eduardomartinez-profile/site-luxif/documento/latex/figuras/esquema.tex

\begin{circuitikz}[american, scale=0.95, transform shape]
  % Arduino
  \draw[thick] (0,0) rectangle (3,9);
  \node[align=center, font=\bfseries] at (1.5,4.6) {Arduino\\Uno};

  % Pinos do lado direito: faixas e leitura
  \foreach \y/\p in {8.5/D2, 7.5/D3, 6.5/D4, 5.5/D5} {
    \node[anchor=east, font=\small] at (3,\y) {\p};
  }
  \node[anchor=east, font=\small] at (3,3.5) {A0};

  \draw (3,8.5) -- (4,8.5) to[R, l=$1\,\mathrm{k\Omega}$] (6.5,8.5) -- (7.5,8.5);
  \draw (3,7.5) -- (4,7.5) to[R, l=$10\,\mathrm{k\Omega}$] (6.5,7.5) -- (7.5,7.5);
  \draw (3,6.5) -- (4,6.5) to[R, l=$100\,\mathrm{k\Omega}$] (6.5,6.5) -- (7.5,6.5);
  \draw (3,5.5) -- (4,5.5) to[R, l=$470\,\mathrm{k\Omega}$] (6.5,5.5) -- (7.5,5.5);
  \draw (7.5,8.5) -- (7.5,3.5);
  \foreach \y in {7.5, 6.5, 5.5} { \fill (7.5,\y) circle (2pt); }
  \draw (3,3.5) -- (7.5,3.5);
  \fill (7.5,3.5) circle (2pt);
  \draw (7.5,3.5) to[phR, l=LDR] (7.5,1) node[ground]{};

  % LEDs azuis do lado esquerdo
  \foreach \y/\p in {8.5/D6, 7.5/D7, 6.5/D8, 5.5/D9} {
    \node[anchor=west, font=\small] at (0,\y) {\p};
    \draw (0,\y) -- (-0.8,\y) to[led] (-2.4,\y) to[R, l_=$1\,\mathrm{k\Omega}$] (-4.6,\y) -- (-5.2,\y);
  }
  \node[font=\small] at (-1.6,9.3) {LEDs azuis};
  \draw (-5.2,8.5) -- (-5.2,4.8) node[ground]{};
  \foreach \y in {7.5, 6.5, 5.5} { \fill (-5.2,\y) circle (2pt); }

  % Alimentação
  \node[anchor=west, font=\small, align=left] at (0,2.5) {Conector\\[-2pt]de energia};
  \node[anchor=north, font=\small] at (1.5,0.6) {GND};
  \draw (-6.5,0) to[battery1, l=$9\,\mathrm{V}$] (-6.5,2.5)
        to[nos, l=chave] (-3.5,2.5) -- (0,2.5);
  \fill (-2,2.5) circle (2pt);
  \draw (-2,2.5) to[led, l_=\small vermelho] (-2,0.6) to[R, l=$1\,\mathrm{k\Omega}$] (-2,-1) -- (-2,-1.3);
  \draw (-6.5,0) -- (-6.5,-1.3) -- (1.5,-1.3) -- (1.5,0);
  \fill (-2,-1.3) circle (2pt);
  \draw (1.5,-1.3) node[ground]{};

  % Display OLED: alimentado por 5V e GND, dados em A4 (SDA) e A5 (SCL)
  \draw[thick] (0.1,10.6) rectangle (2.9,11.6);
  \node[font=\small\bfseries] at (1.5,11.1) {Display OLED};
  \foreach \x/\p in {0.4/GND, 1.1/5V, 1.9/A4, 2.6/A5} {
    \draw (\x,9) -- (\x,10.6);
    \node[anchor=south, font=\scriptsize] at (\x,9) {\p};
  }
\end{circuitikz}
