eduardomartinez-profile/site-luxif/imagens/esquema-eletrico.png

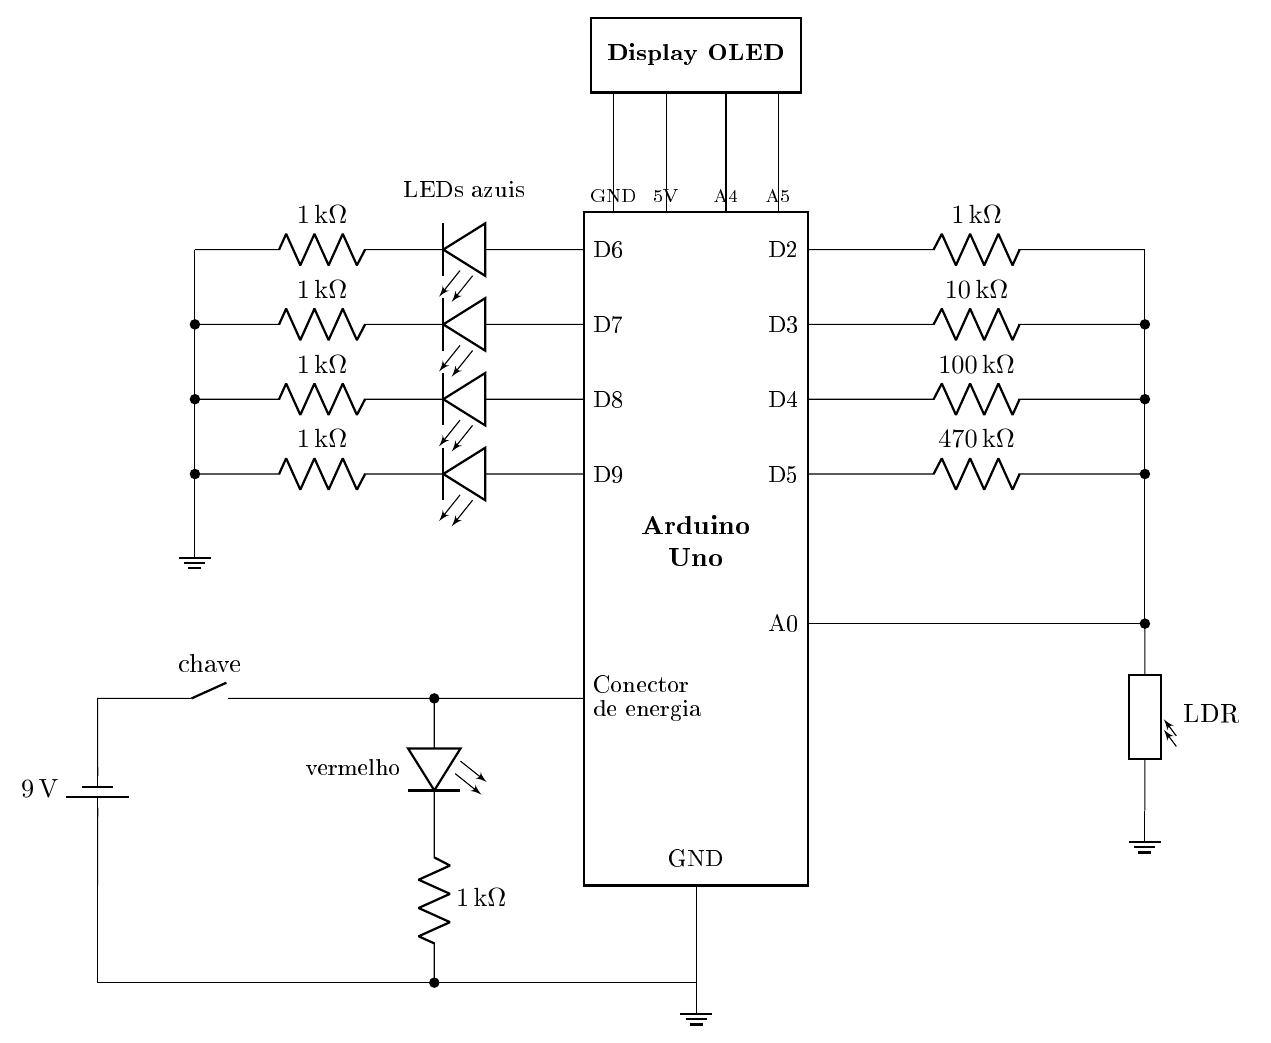
imagens/esquema-eletrico.png
