eduardomartinez-profile/site-luxif/imagens/grafico-divisor.png

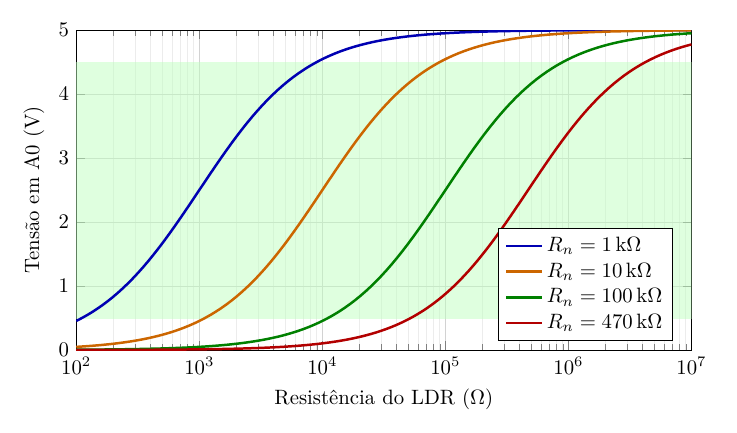
imagens/grafico-divisor.png
