eduardomartinez-profile/site-luxif/imagens/grafico-ldr.png

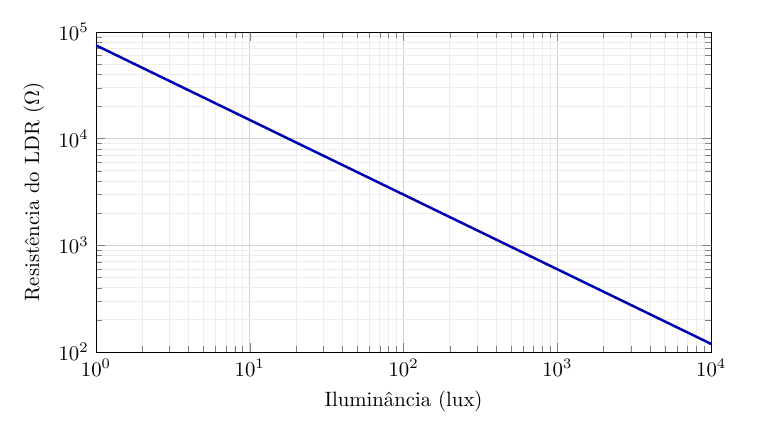
imagens/grafico-ldr.png
